DanielCheung16/Face_Verification_Accelerator-NPU/frontend/Design_ideal_for_dw_conv3x3_and _general_conv3x3.md

# 总设计思路

## 1. PE array 设计
本设计只使用一个 `3×3 PE array` 来实现所有 `DWConv3×3` 和普通 `Conv3×3`。
该 array 采用普通 MAC 结构。每个 PE 负责一个 window element 和 filter element 的乘法，例如：

```text
PE00 = A00 × W00
PE01 = A01 × W01
...
PE22 = A22 × W22
````
因此，一个 `3×3 PE array` 一次完成 9 个 MAC，对应一个 `3×3 filter` 和一个 `3×3 activation window` 的 dot product。

## 2. 按 channel 方向计算

为了配合 `Conv1×1`，global buffer 中的 activation 采用 `HWC` 存储方式：

```text
I[y][x][c]
```

也就是同一个 pixel 下的多个 channel 连续存储。

同时，global buffer 一次读取宽度为：

```text
128 bits = 16 Bytes = 16 个 INT8 channel
```

如果按照传统 sliding window 的方式先固定 `ic`，那么每次 128-bit 读取中只会使用 1 Byte，剩下 15 Bytes 会被浪费。这样不仅降低读取带宽利用率，也会增加加载延时。并且由于输出仍然需要写回成 HWC 格式，若每次只生成 1 Byte output，也无法高效利用 128-bit 写宽。

因此，本设计选择沿 channel 方向计算。也就是说，先固定空间位置：

```text
output[y][x]
```

然后依次计算该位置下连续 16 个 output channel 的结果。

## 3. Activation buffer 设计

对于一个固定的 `output[y][x]`，需要读取一个 `3×3 activation window`。

由于每次读取 128 bits，所以一个 window 需要：

```text
9 × 128-bit activation words
```

也就是：

```text
9 × 16 Bytes
```

每个 128-bit word 包含同一个空间位置下的 16 个连续 channel。

因此 activation buffer 可以设计为：

```text
9 × 16 Bytes
```

为了隐藏 activation load latency，采用 ping-pong buffer：

```text
activation buffer A：用于当前 window 计算
activation buffer B：同时加载下一个 window
```

所以总 activation buffer 大小为：

```text
2 × 9 × 16 Bytes
```

## 4. Weight buffer 设计

当 `output[y][x]` 的 16 个 channel 计算完成后，下一步会移动到下一个空间位置。但对于 DWConv3×3 来说，filter weight 在整个 feature map 扫描过程中保持不变。

因此，weight 可以加载到本地 buffer 中复用，而不是每个 window 重新加载。

最大 `Cin = 512` 时，DWConv3×3 的 weight 大小为：

```text
512 channels × 9 Bytes = 4608 Bytes = 4.5 KB
```

因此可以设计：

```text
9 个 512-Byte weight buffer
```

等价于：

```text
512 channels × 9 kernel positions
```

这样每一层 DWConv3×3 只需要加载一次 weight，之后在所有 `x, y` 位置上反复复用。

## 5. Load 和 compute 的关系

一个 cycle 只能分别加载：

```text
16 Bytes activation
16 Bytes weight
```

因此，填满一个 `3×3 activation window` 需要：

```text
9 cycles
```

但是这一次加载得到的是 16 个 channel 的数据。由于当前只有一个 `3×3 PE array`，所以 16 个 channel 需要分 16 cycles 依次计算：

```text
cycle 0  → channel c+0
cycle 1  → channel c+1
...
cycle 15 → channel c+15
```

也就是说：

```text
load time    = 9 cycles
compute time = 16 cycles
```

使用 ping-pong activation buffer 后，可以在当前 window 计算的 16 cycles 内加载下一个 window 的 9 cycles 数据。

因此在 steady state 下，activation load latency 可以被 compute 完全隐藏，整体吞吐主要由 16-cycle compute 决定。

## 6. 总结

本设计的核心是：

```text
1. Conv1×1 继续使用 HWC layout，以适配 systolic array。
2. DWConv3×3 / Conv3×3 使用一个普通 3×3 PE array。
3. 为了匹配 128-bit HWC 读写宽度，spatial engine 按 16-channel tile 计算。
4. Weight 使用 512 × 9 Bytes 本地 buffer，实现整层复用。
5. Activation 只缓存当前 3×3 window，并采用 ping-pong buffer 隐藏加载延时。
6. Steady state 下，每个 output[y][x] 的 16-channel tile 约需要 16 cycles 完成。
```
设计方略：DWConv3x3 / general Conv3x3 先共用一个普通 3x3 PE array，固定 spatial 位置后沿 channel tile 方向计算，以匹配 HWC layout 和 SRAM word bandwidth。

# 模块实现
## computational unit
端口信号应该为：
9个8bits weight输入，9个8bits activation输入， enable进行一次整个array计算的全局使能信号（input），32bits的输出psum信号，考虑到要要多级pipeline（因为把9个mul结果加起来不能和mul放一起，且加法链长）所以需要一个valid output信号（这个信号其实就把输入enable也通过同样等级数的pipeline，这样就对齐了）

## local buffer设计：
然后实现activation和weight的local buffer。（这两个可以统一设计成参数化的）
写端口：128bits的data in, clear信号重置pointer到buffer起始位置，wr_en写使能
读端口：8bits的data out，配合data valid, 需要有rd_idx(或者叫rd_addr), 以及地址有效信号（或者是读使能信号）
参数化部分：可以调节一128bits为倍数的深度

all_weights_loaded_o现在是整个9个buffer完全写满了后拉高。weights_loaded_o写完一个完整tile后拉高。
```
cycle N:
  写入当前 word group 的第 9 个 kernel position

cycle N 后:
  weights_loaded_o = 1
  表示这个完整 3x3 filter tile 已经可以读

如果这是最后一个 DEPTH word group:
  all_weights_loaded_o = 1
  表示 9 个 buffer 的整个 depth 都写满了

weights_loaded_o 会保持到下一组 weight tile 开始写入时清掉。
all_weights_loaded_o 一旦拉高，会保持到 clear_i。
```

### load part
```
config gives:
  act_base
  ifmap_size
  num_filter
  row_stride = ifmap_size * num_filter
  pixel_stride = num_filter

runtime counters:
  x_cnt, y_cnt, tile_cnt

runtime base:
  tile_offset = tile_cnt * 16       // increment by 16
  pixel_base = row_base + y offset + tile_offset

window address:
  precomputed 9 registered addresses

```

我觉得现在这个方案ok，有几个细节再讨论一下：
1. 是不是一般考虑x,y是考虑filter的中心点会比较多（or更加合理？），这样就是win_row0_base - pixel_stride.
2. 由于我们现在weight ram和A/O ram是分开的。所以FSM的act和wait应该是同时的。
3. 还需要考虑padding 0 和 stride =2情况。

```
win_x0 = out_x * stride - 1
win_y0 = out_y * stride - 1

```
样比“x/y 就是 center”更通用，因为 layer 的输出遍历天然是按 output coordinate 走的。stride=1/2、padding、输出尺寸判断也都围绕 output pixel 更清楚。

### window_generator:
应该由 window_generator 上层产生
- clear_i：layer 开始时清 act ping-pong 和 weight buffer。这个是 layer lifecycle，不属于 window_generator 自己决定。
- swap_i：当前 window compute 完成、next window 已加载完成时，由上层根据 ping-pong 调度决定。
- layer_start_i：由 spatial layer inside controller 发出。
- load_start_i：由上层在某个 output pixel/tile 需要 preload 时发出。
- out_x_i/out_y_i/tile_offset_i：由上层 spatial layer inside controller 的坐标 counter 产生。
- act_base/wgt_base/ifmap_size/code/stride/pad/current_num_filter：layer config，来自 layer_switcher/config ROM。

## 回写逻辑
因为我们读取就已经是天然的HWC的了，回写很自然类似与streaming，地址也是HWC的。所以不去与conv1x1共用回写逻辑。
结构（boundary）是这样：
spatial_wb.sv:
  small_output_process（用来支持bypass quant, PReLu, requant, residual）
  pack_writeback:
    address generator
    package128（pack的8bits to 32bits,考虑是否最终不满128bits的情况？）
    如果有不满128bits的情况，需要额外设定mask

其中small_output_process这里可以做pipeline的用来提高频率。（因为是stream也就只有初始有影响）
pack_writeback输出的回写端口最终应该与A/O buffer的要求对齐。

# 整体设计
关于post process要处理的重要问题：
```
我们要认真考虑综合、功能正确和时序的问题：
1.你现在rom的宽度是多少？
2. 但是你前面有说过：但它不应该把每个 channel 的 multiplier/bias 全部摊平成一堆端口直接输出。否则 fanout 和接口都会爆炸。现在这个结果会不会有这个问题。
3. Per-channel 参数应该存在哪里？它应该暴露给哪一层？
4. switcher应该包含哪些职责（主要是它负不负责 Per-channel 参数？还是这个参数完全写在另一个存储然后给到两个post process？
```

## 关于postprocess的设计手则
在完成我们这一阶段设计前，请你记住设计守则：
1. Switcher 管 layer 调度和 SRAM ownership；layer_config_rom 管每层 metadata；quant_param_rom 管 per-channel 参数；各 layer/postprocess 自己根据数据流调度 per-channel 参数。
2. 调度器放在各top里面，quant_param_mem作为全局共享存储放在各top外面
3.结构：
```
layer_switcher
  ├─ layer_config_mem
  ├─ SRAM ownership mux
  └─ start/done scheduling

conv1x1_top
  ├─ conv1x1 compute
  ├─ conv1x1_param_scheduler
  └─ conv1x1_output_postprocess

spatial_top
  ├─ spatial3x3_dev
  ├─ spatial_param_scheduler
  ├─ small_output_process
  └─ spatial_pack_writeback
```
4. 需要是可综合设计。涉及到rom/ram的部分，一定是要按照能综合成memory的写法（要考虑接口大小，深度，读取数量）
5. 宽bit大扇出的全局控制信号，考虑到net delay问题。如果不影响steady status，那么可以考虑加本地reg做间隔。输出在允许的情况下经历reg输出。

## 系统级验证方案
```
prelu_plus_activation_quant
  = PReLU + requant

activation_quant_or_residual_add_quant
  = requant
  or residual + requant
```

软件层面应该把quantize的部分融合到其上层。记住`mobilefacenet_hw_simplified.csv`是你对于层级了解的关键文件。我们应该依次进行如下验证：
因为我们之前通过过conv1x1的，但改了一些模块，所以现在先重新验证一下。
1. conv1x1 + requant

2. conv1x1 + （PReLU + requant）

3. conv1x1 + （residual + requant）
   这是最该补的，因为它验证 conv1x1 residual path、residual SRAM read、param scheduler 对齐

4. conv1x1 有两层放在一起。比如cvs:conv1x1 + conv1x1 + prelu_plus_activation_quant。然后验证conv1x1 + （residual +     requant再conv1x1 + （PReLU + requant）

开始dwconv的部分
dwconv3x3好像不需要支持residual
1. dwconv3x3 + PReLU + requant
   刚刚做过 spatial_top，但还不是完整 top；之后可以升级到 top 单层验证

2. 可以开做dwconv3x3 和conv1x1的联合验证了：
   第一个：conv1x1 + (conv1x1 + prelu_plus_activation_quant) + (dwconv3x3 + prelu_plus_activation_quant) + (conv1x1 + activation_quant_or_residual_add_quant)
   第二个：（conv1x1 + activation_quant_or_residual_add_quant）+ （conv1x1 + prelu_plus_activation_quant）+ （dwconv3x3 + prelu_plus_activation_quant） + （conv1x1 + activation_quant_or_residual_add_quant）

3. 验证stride=2 的dwconv3x3： （dwconv3x3 + prelu_plus_activation_quant）

4. 验证stride=2 的dwconv3x3与紧接着的下层conv1x1 （dwconv3x3 + prelu_plus_activation_quant）+ （conv1x1 + requant0）

4. conv3x3 + postprocess
   等 conv3x3 compute controller 完成后补

## 一直遵守的设计与验证手则
1. 需要是可综合设计。涉及到rom/ram的部分，一定是要按照能综合成memory的写法（要考虑接口大小，深度，读取数量）
2. 宽bit大扇出的全局控制信号，考虑到net delay问题。如果不影响steady status，那么可以考虑加本地reg做间隔。输出在允许的情况下经历reg输出。
3. 注意你C model的可配置性（可选layers），我不希望你每次都要重新写很多C code。不要去动之前做过精确性检查的那个最重要整个系统的golden c。
4. 不到万不得已的地方，尽量不要用function。
5. 遇到错误时（特别时多层layer一起时），首先检查tb检查的地址是否out_base_addr匹配。（这可能导致回写覆盖等问题）

## 支持普通conv3x3的设计
```
spatial_top
  ├─ spatial3x3_dev
  │   ├─ window_generator
  │   ├─ spatial3x3_pe_array
  |   ├─ spatial_inside_controller
  │   └─ spatial_ic_accumulator
  ├─ spatial_param_scheduler
  └─ spatial_wb
```
1. 添加spatial_ic_accumulator用于做累加。
2. spatial_inside_controller应该自己通过ic来判断是否做累加结束了（是否当前要用的层加载完毕了）。
3. 为了支持pad（不能直接用0），**每一layer**有自己的pad_value(8bits)，很适合放在layer_config_mem中。
