DanielCheung16/Face_Verification_Accelerator-NPU/frontend/rtl/src/quantface_conv1x1_params_pkg.sv

package quantface_conv1x1_params_pkg;
    function automatic int qf_num_layers();
        qf_num_layers = 2;
    endfunction

    function automatic logic signed [63:0] qf_bias;
        input int layer;
        input int ch;
        begin
            qf_bias = 64'sd0;
            case (layer)
                0: begin
                    case (ch)
                        0: qf_bias = 64'sd1719387904;
                        1: qf_bias = -64'sd2651127296;
                        2: qf_bias = -64'sd3618003456;
                        3: qf_bias = 64'sd423978368;
                        4: qf_bias = -64'sd828367552;
                        5: qf_bias = 64'sd2296628736;
                        6: qf_bias = -64'sd329751488;
                        7: qf_bias = 64'sd245022912;
                        8: qf_bias = 64'sd486360448;
                        9: qf_bias = 64'sd2244879360;
                        10: qf_bias = 64'sd3993342464;
                        11: qf_bias = -64'sd330327136;
                        12: qf_bias = 64'sd4868288512;
                        13: qf_bias = -64'sd1843590912;
                        14: qf_bias = -64'sd266417152;
                        15: qf_bias = -64'sd5015337984;
                        16: qf_bias = -64'sd1071040896;
                        17: qf_bias = 64'sd367139392;
                        18: qf_bias = -64'sd1928932480;
                        19: qf_bias = 64'sd1658808064;
                        20: qf_bias = 64'sd2862805760;
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
                        126: qf_residual_zero_point = 0;
                        127: qf_residual_zero_point = 0;
                        default: ;
                    endcase
                end
                default: ;
            endcase
        end
    endfunction

endpackage
