DanielCheung16/Face_Verification_Accelerator-NPU/frontend/rtl/src/gdconv7x7_core.sv

module gdconv7x7_core #(
    parameter int DATA_W       = 8,
    parameter int ACC_W        = 32,
    parameter int GB_DATA_W    = 128,
    parameter int GB_ADDR_W    = 16,
    parameter int CHANNELS     = 512,
    parameter int KERNEL_ELEMS = 49,

    localparam int LANES = GB_DATA_W / DATA_W,
    localparam int LANE_W = (LANES <= 1) ? 1 : $clog2(LANES),
    localparam int CHANNEL_W = (CHANNELS <= 1) ? 1 : $clog2(CHANNELS),
    localparam int KPOS_W = (KERNEL_ELEMS <= 1) ? 1 : $clog2(KERNEL_ELEMS),
    localparam int WORDS_PER_KPOS = (CHANNELS + LANES - 1) / LANES
) (
    input  logic clk,
    input  logic rst_n,
    input  logic run_en_i,

    input  logic start_i,
    output logic busy_o,
    output logic done_o,

    input  logic [GB_ADDR_W-1:0] act_base_addr_i,
    input  logic [GB_ADDR_W-1:0] wgt_base_addr_i,

    output logic                 gb_act_rd_valid_o,
    output logic [GB_ADDR_W-1:0] gb_act_rd_addr_o,
    input  logic [GB_DATA_W-1:0] gb_act_rd_data_i,

    output logic                 gb_wgt_rd_valid_o,
    output logic [GB_ADDR_W-1:0] gb_wgt_rd_addr_o,
    input  logic [GB_DATA_W-1:0] gb_wgt_rd_data_i,

    output logic                         psum_valid_o,
    output logic [CHANNEL_W-1:0]         psum_channel_o,
    output logic signed [ACC_W-1:0]      psum_o
);
    typedef enum logic [1:0] {
        IDLE,
        RUN,
        DONE
    } state_t;

    state_t state, state_nxt;

    logic [CHANNEL_W-1:0] ch_cnt, ch_cnt_nxt;
    logic [KPOS_W-1:0] kpos_cnt, kpos_cnt_nxt;
    logic [GB_ADDR_W-1:0] act_addr, act_addr_nxt;
    logic [GB_ADDR_W-1:0] wgt_addr, wgt_addr_nxt;
    logic signed [ACC_W-1:0] acc, acc_nxt;

    logic pending_valid, pending_valid_nxt;
    logic pending_last, pending_last_nxt;
    logic [LANE_W-1:0] pending_lane, pending_lane_nxt;

    logic [GB_ADDR_W-1:0] ch_word_offset_w;
    logic [LANE_W-1:0] ch_lane_w;
    logic [CHANNEL_W-1:0] next_ch_w;
    logic [GB_ADDR_W-1:0] next_ch_word_offset_w;
    logic signed [DATA_W-1:0] act_byte_w;
    logic signed [DATA_W-1:0] wgt_byte_w;
    logic signed [(2*DATA_W)-1:0] product_w;
    logic signed [ACC_W-1:0] product_ext_w;
    logic signed [ACC_W-1:0] acc_sum_w;
    logic issue_read_w;
    logic kpos_last_w;
    logic ch_last_w;

    assign busy_o = (state != IDLE);

    assign ch_word_offset_w = GB_ADDR_W'(ch_cnt >> LANE_W);
    assign ch_lane_w = ch_cnt[LANE_W-1:0];
    assign next_ch_w = ch_cnt + CHANNEL_W'(1);
    assign next_ch_word_offset_w = GB_ADDR_W'(next_ch_w >> LANE_W);

    assign act_byte_w = gb_act_rd_data_i[pending_lane*DATA_W +: DATA_W];
    assign wgt_byte_w = gb_wgt_rd_data_i[pending_lane*DATA_W +: DATA_W];
    assign product_w = act_byte_w * wgt_byte_w;
    assign product_ext_w = {{(ACC_W-(2*DATA_W)){product_w[(2*DATA_W)-1]}}, product_w};
    assign acc_sum_w = acc + product_ext_w;

    assign kpos_last_w = (kpos_cnt == KPOS_W'(KERNEL_ELEMS - 1));
    assign ch_last_w = (ch_cnt == CHANNEL_W'(CHANNELS - 1));
    assign issue_read_w = (state == RUN) && run_en_i && !(pending_valid && pending_last);

    always_comb begin
        state_nxt = state;
        ch_cnt_nxt = ch_cnt;
        kpos_cnt_nxt = kpos_cnt;
        act_addr_nxt = act_addr;
        wgt_addr_nxt = wgt_addr;
        acc_nxt = acc;
        pending_valid_nxt = 1'b0;
        pending_last_nxt = 1'b0;
        pending_lane_nxt = pending_lane;

        gb_act_rd_valid_o = 1'b0;
        gb_act_rd_addr_o = act_addr;
        gb_wgt_rd_valid_o = 1'b0;
        gb_wgt_rd_addr_o = wgt_addr;
        psum_valid_o = 1'b0;
        psum_channel_o = ch_cnt;
        psum_o = acc_sum_w;
        done_o = 1'b0;
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
