DanielCheung16/Face_Verification_Accelerator-NPU/(commit log)

2026-04-26 extract the parameters, then starting moduling PE unit
    [layer_shapes_and_params.csv, mobilefacenet_hw_simplified.csv]
2026-05-04 Array Top Version2: add the Preload module, the ports from Preload exposed to standard DDR. This version's systolic array supports stall too, so the banked buffer do not must have valid data every cy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
    [array_controller.sv, array_level2_top.sv, tb_array_controller_skew_addr_gen.sv, tb_array_level2_top.sv]
2026-05-05 Level2 Global Top: The local buffer still use 8KB*2. Add 'gemm_preload' as the intermediate stage between local buffer and the global buffer.
2026-05-08 Whole system version1: the first whole system, and conv1x1 just plays a role in one of the devices; Implement layer_switcher and top.sv; passed top_smoke
2026-05-10 Whole-model C reference for the current hardware quantization spec.
    The goal is not bit-exact QuantFace. The goal is to quantify the error of the
    hardware-friendly model:
    - weight: per-output-channel symmetric int8
    - activation: per-layer asymmetric int8
    - accumulator: int32
    - bias: includes activation zero-point correction and BN folding
    - PReLU: common shift per layer, multiplier per output channel
    - requant: common shift per layer for this first version
    [conv1x1_gb_top.sv, conv1x1_level3_top.sv, conv1x1_output_postprocess.sv]
2026-05-10 Pipeline conv1x1 tile config and preload addresses
    Cache tile/layer constants in conv1x1_level3_top using CONFIG_TILE:
    - register k/m/n sizes and base addresses
    - register row_base/col_base and last_tile
    - register per-output-tile postprocess parameters
    - precompute residual starting address and increment by n_tiles
    Replace dynamic division/modulo in gemm_preload:
    - use activation row/k/lane counters
    - use weight k/col/lane counters
    - remove load_count/k_size and load_count%k_size from active address path
    This preserves module responsibility and only pipelines/caches address/config calculations.
    [conv1x1_level3_top.sv, gemm_preload.sv]
2026-05-15 Stage 1: 1. construct the general MAC PE array. 2. construct the local spatial buffer without read and load controller.
2026-05-17 Postprocess change step1 : change the layer_switcher. Let the switcher implements small output width by just generating the base address for channel parameters
2026-05-18 traditional conv3x3 support 1.3: ”1.Removed `ic_first` and `ic_last` from the controller → accumulator interface. 2.Accumulator now derives IC boundary conditions internally based on `input_channel_c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
2026-05-21 verification input flow: add image export docs and generated input
